maryamxm/monkido/docs/documentations/README.md

# Monkido learning notes

Short refreshers on the embedded concepts Monkido uses. Each one is tied to the functions in the code that use the concept. 

| # | Topic | Covers |
|---|---|---|
| [01](01-gpio.md) | GPIO | Register lists and how they are used in the project
| [02](02-timer1.md) | Timer1 | Register lists and how they are used in the project
| [03](03-uart.md) | USART | Register lists and how they are used in the project

Note: the documentation is not complete and it will be with the V2 of the game :)
