maryamxm/monkido/docs/images/hardware3.JPG

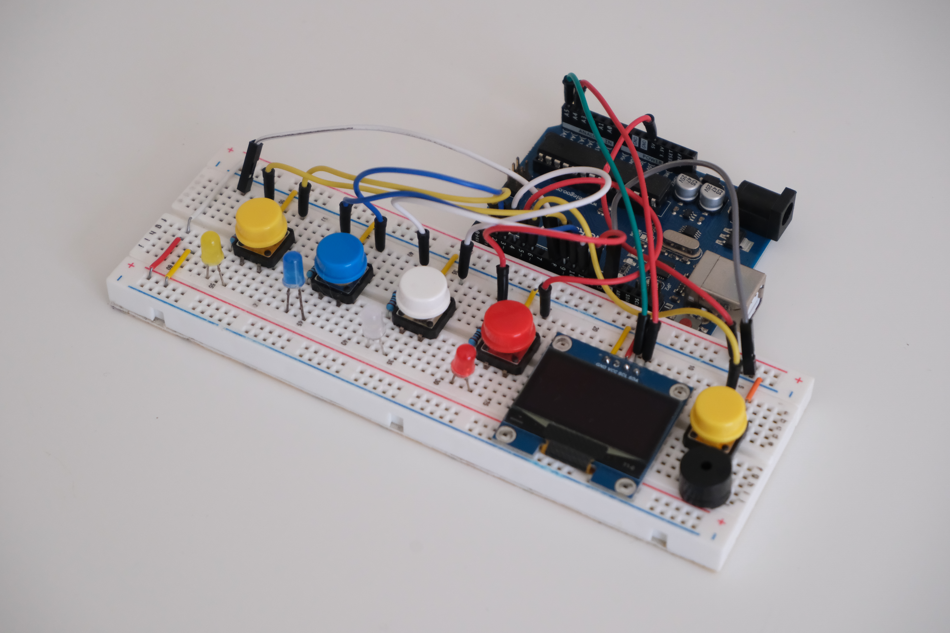
docs/images/hardware3.JPG
