maryamxm/monkido/docs/images/hardware4.png

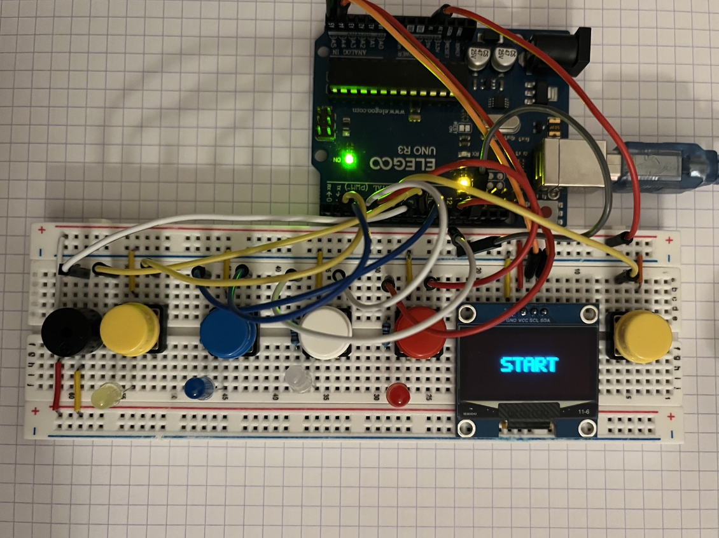
docs/images/hardware4.png
