maryamxm/monkido/docs/hardware/schematic.pdf

A

1 | 2 | 3 | 4 | 5 | 6

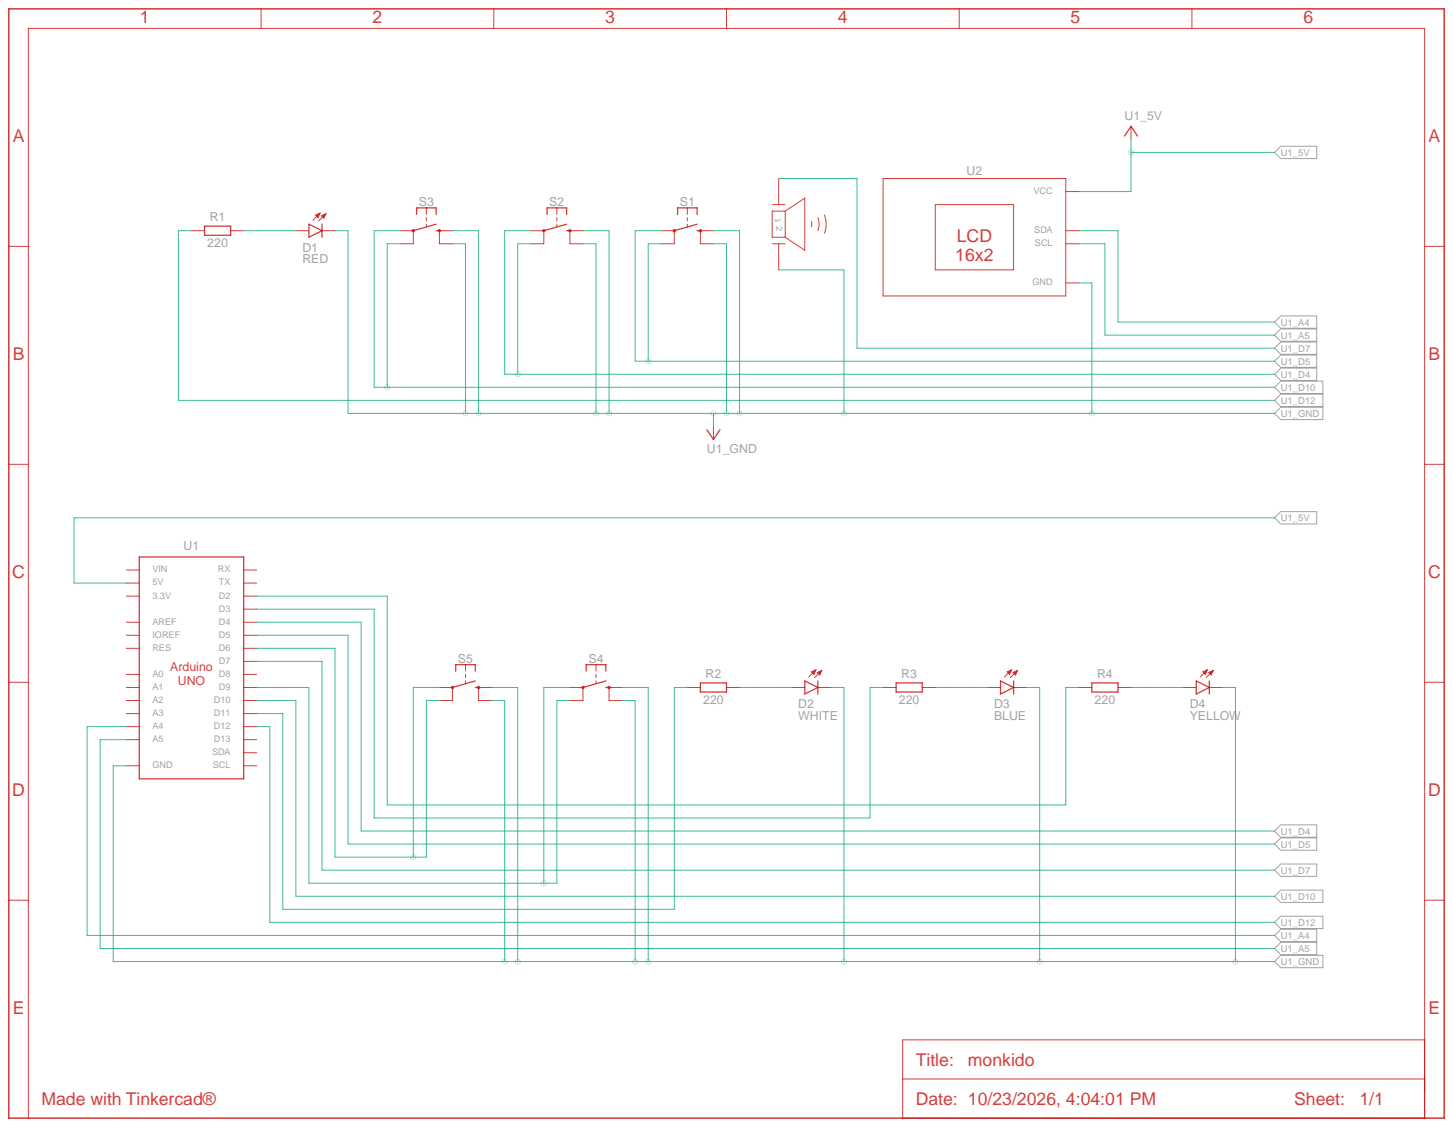
[picture p5: page 1]
