maryamxm/monkido/(commit log)

2026-10-22 timer1 doc
2026-10-24 schematic update
